antoniog11/iris-hardware/README.md

# IRIS Ring Hardware
KiCad schematic and PCB design for [IRIS: Wireless ring for vision-based smart home interaction](https://dl.acm.org/doi/10.1145/3654777.3676327).
