antoniog11/iris-hardware/balsamic 2.kicad_pcb

## KiCad design balsamic 2.kicad_pcb (2025-05-01)

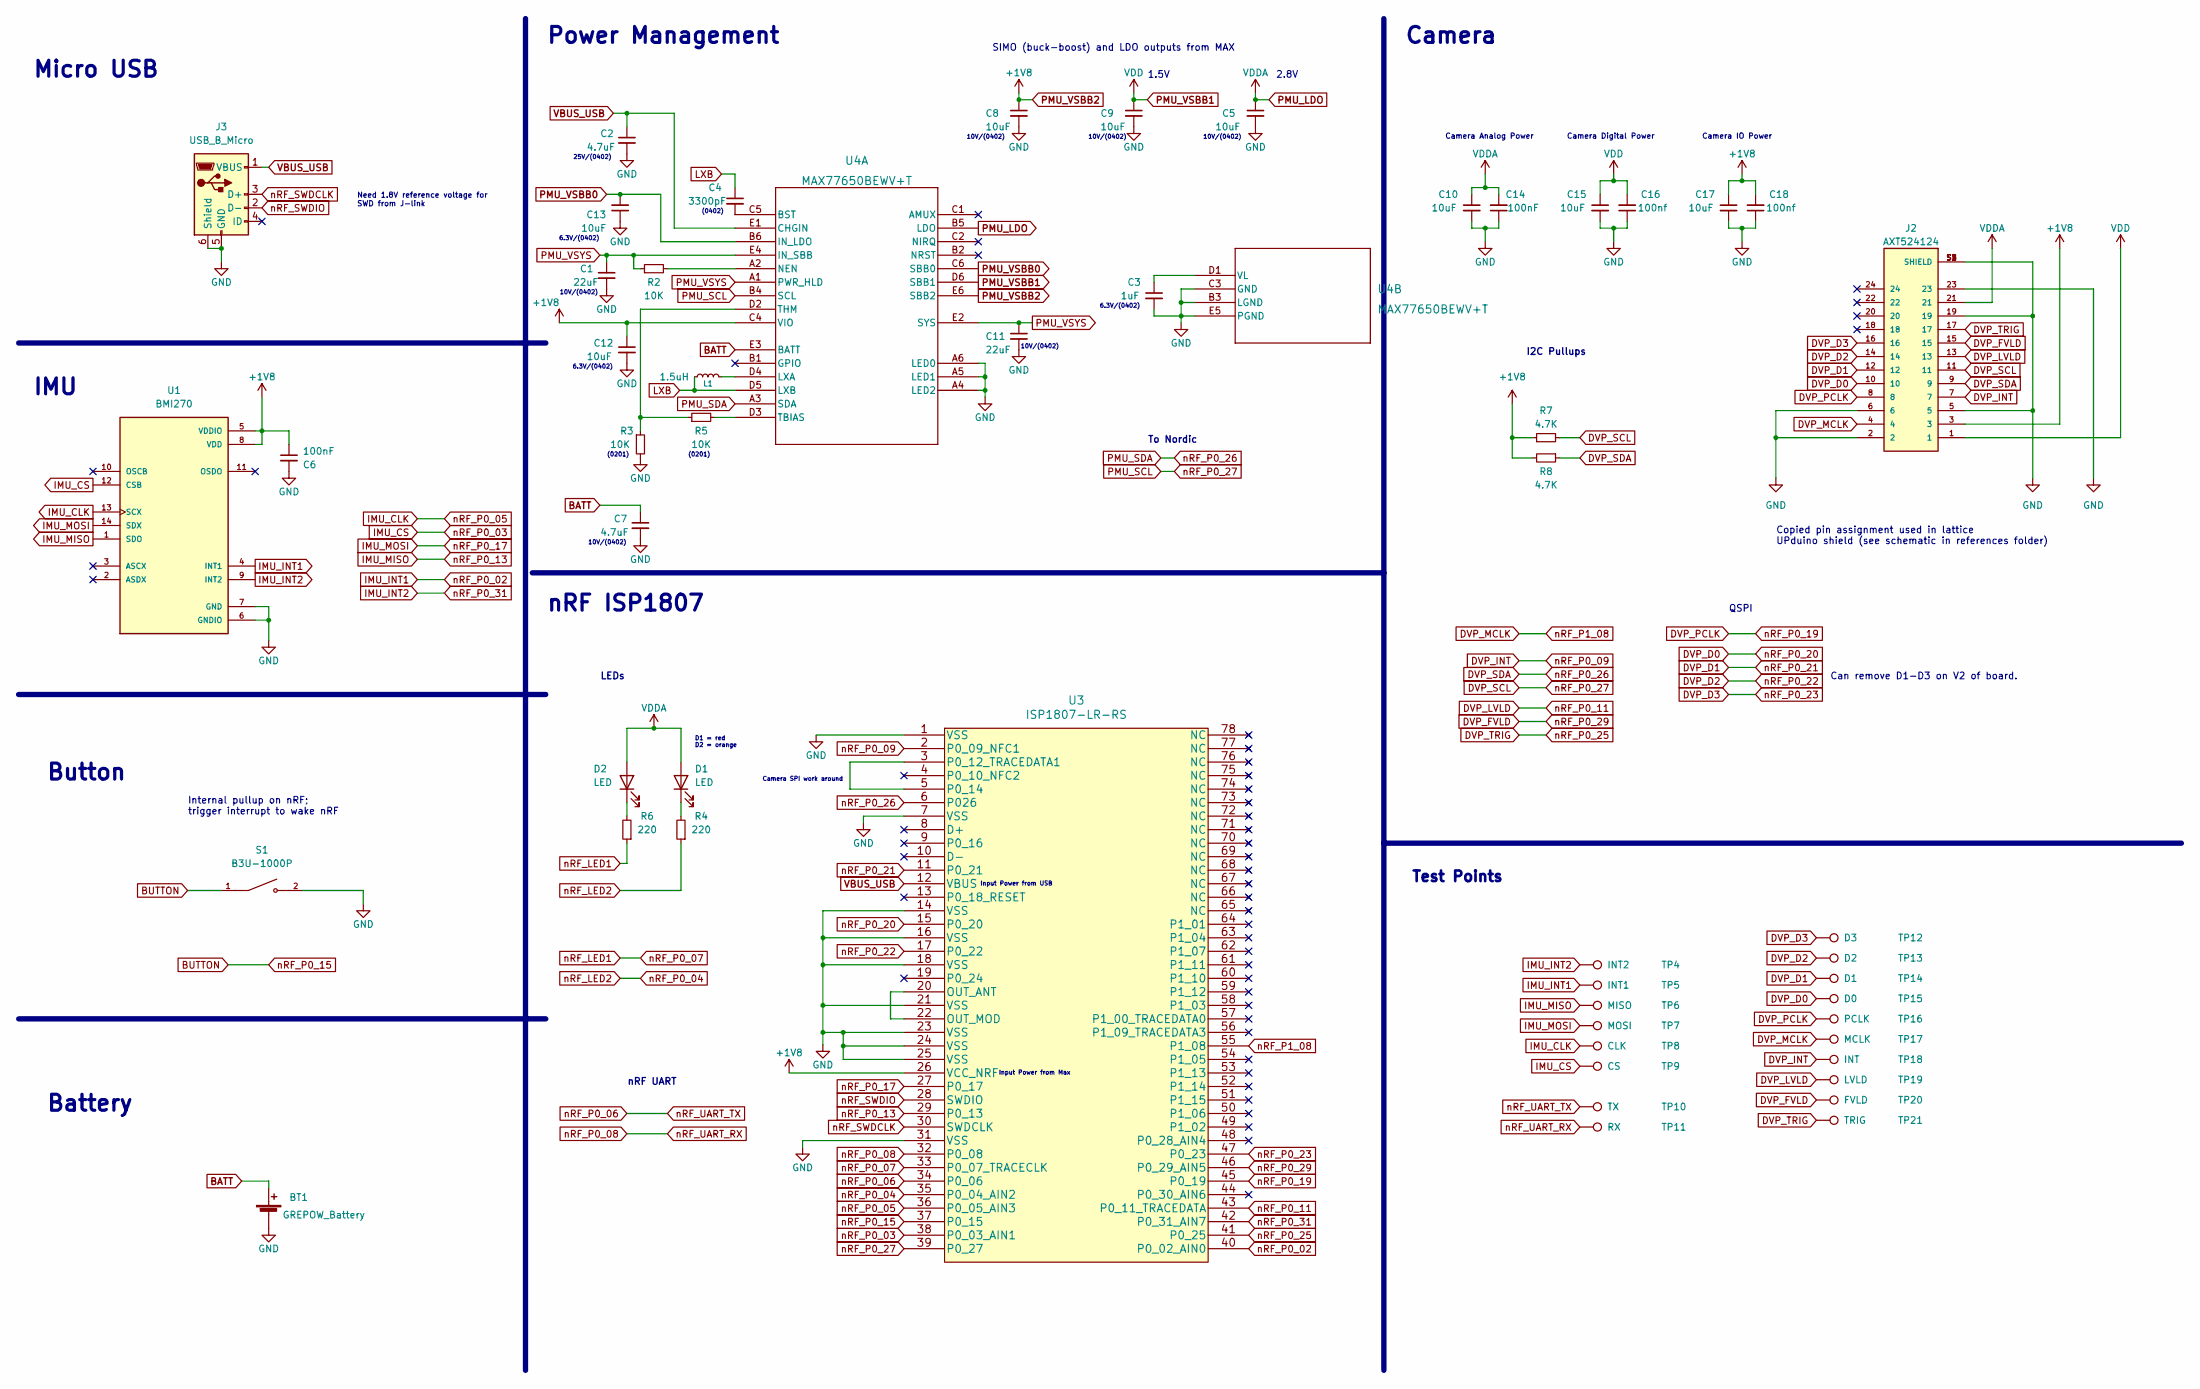
[picture p1: schematic balsamic 2.kicad_sch]

Parts:
BT1: GREPOW_Battery; balsamic_grepow_battery
C1, C11: 22uF; C_0402_1005Metric
C2, C7: 4.7uF; C_0402_1005Metric
C3: 1uF; C_0402_1005Metric
C4: 3300pF; C_0402_1005Metric
C5, C8, C9, C12, C13, C15, C17: 10uF; C_0402_1005Metric
C6, C14: 100nF; C_0201_0603Metric
C10: 10uF; C_0402_1005Metric_Pad0.74x0.62mm_HandSolder
C16, C18: 100nf; C_0201_0603Metric
D1, D2: LED; LED_0402_1005Metric
J2: AXT524124; PANASONIC_AXT524124
J3: USB_B_Micro; USB_Micro-B_GCT_USB3076-30-A
L1: 1.5uH; L_0805_2012Metric
R2, R3, R5: 10K; R_0201_0603Metric
R4, R6: 220; R_0201_0603Metric
R7, R8: 4.7K; R_0201_0603Metric
S1: B3U-1000P; SW_B3U-1000P
TP4: INT2; TestPoint_Pad_D0.5mm
TP5: INT1; TestPoint_Pad_D0.5mm
TP6: MISO; TestPoint_Pad_D0.5mm
TP7: MOSI; TestPoint_Pad_D0.5mm
TP8: CLK; TestPoint_Pad_D0.5mm
TP9: CS; TestPoint_Pad_D0.5mm
TP10: TX; TestPoint_Pad_D0.5mm
TP11: RX; TestPoint_Pad_D0.5mm
TP12: D3; TestPoint_Pad_D0.5mm
TP13: D2; TestPoint_Pad_D0.5mm
TP14: D1; TestPoint_Pad_D0.5mm
TP15: D0; TestPoint_Pad_D0.5mm
TP16: PCLK; TestPoint_Pad_D0.5mm
TP17: MCLK; TestPoint_Pad_D0.5mm
TP18: INT; TestPoint_Pad_D0.5mm
TP19: LVLD; TestPoint_Pad_D0.5mm
TP20: FVLD; TestPoint_Pad_D0.5mm
TP21: TRIG; TestPoint_Pad_D0.5mm
U1: BMI270; XDCR_BMI270
U3: ISP1807-LR-RS
U4: MAX77650BEWV+T; 21-100047A_W302H2&plus_1_MXM

Connections:
BATT: BT1.1 (+), C7.1, U4.E3 (BATT); also elsewhere on the board
BUTTON: S1.1, U3.37 (P0_15)
DVP_D0: J2.10, TP15.1, U3.15 (P0_20)
DVP_D1: J2.12, TP14.1, U3.11 (P0_21)
DVP_D2: J2.14, TP13.1, U3.17 (P0_22)
DVP_D3: J2.16, TP12.1, U3.47 (P0_23)
DVP_FVLD: J2.15, TP20.1, U3.46 (P0_29_AIN5)
DVP_INT: J2.7, TP18.1, U3.2 (P0_09_NFC1)
DVP_LVLD: J2.13, TP19.1, U3.43 (P0_11_TRACEDATA)
DVP_MCLK: J2.4, TP17.1, U3.55 (P1_08)
DVP_PCLK: J2.8, TP16.1, U3.45 (P0_19)
DVP_SCL: J2.11, R7.2, U3.39 (P0_27), U4.B4 (SCL)
DVP_SDA: J2.9, R8.1, U3.6 (P026), U4.A3 (SDA)
DVP_TRIG: J2.17, TP21.1, U3.41 (P0_25)
GND: BT1.2 (-), C1.2, C2.2, C3.2, C5.2, C6.2, C7.2, C8.2, C9.2, C10.2, C11.2, C12.2, C13.1, C14.1, C15.2, C16.1, C17.2, C18.1, J2.2, J2.5, J2.6, J2.19, J2.23, J2.S1 (SHIELD), J2.S2 (SHIELD), J2.S3 (SHIELD), J2.S4 (SHIELD), J3.5 (GND), J3.6 (Shield), R3.2, S1.2, U1.6 (GNDIO), U1.7 (GND), U3.1 (VSS), U3.7 (VSS), U3.14 (VSS), U3.16 (VSS), U3.18 (VSS), U3.21 (VSS), U3.23 (VSS), U3.24 (VSS), U3.25 (VSS), U3.31 (VSS), U4.A4 (LED2), U4.A5 (LED1), U4.A6 (LED0), U4.B3 (LGND), U4.C3 (GND), U4.E5 (PGND); also elsewhere on the board
IMU_CLK: TP8.1, U1.13 (SCX), U3.36 (P0_05_AIN3)
IMU_CS: TP9.1, U1.12 (CSB), U3.38 (P0_03_AIN1)
IMU_INT1: TP5.1, U1.4 (INT1), U3.40 (P0_02_AIN0)
IMU_INT2: TP4.1, U1.9 (INT2), U3.42 (P0_31_AIN7)
IMU_MISO: TP6.1, U1.1 (SDO), U3.29 (P0_13)
IMU_MOSI: TP7.1, U1.14 (SDX), U3.27 (P0_17)
LXB: C4.1, L1.1, U4.D5 (LXB)
unnamed: C4.2, U4.C5 (BST)
unnamed: D1.1 (K), R4.2
unnamed: D2.1 (K), R6.2
unnamed: L1.2, U4.D4 (LXA)
unnamed: R2.2, U4.A2 (NEN)
unnamed: R3.1, R5.1, U4.D2 (THM)
unnamed: R5.2, U4.D3 (TBIAS)
unnamed: U3.3 (P0_12_TRACEDATA1), U3.5 (P0_14)
unnamed: U3.20 (OUT_ANT), U3.22 (OUT_MOD)
unnamed: C3.1, U4.D1 (VL)
PMU_LDO: C5.1, C10.1, C14.2, D1.2 (A), D2.2 (A), J2.21, U4.B5 (LDO)
PMU_VSBB0: C13.2, U4.B6 (IN_LDO), U4.C6 (SBB0)
PMU_VSBB1: C9.1, C15.1, C16.2, J2.1, U4.D6 (SBB1)
PMU_VSBB2: C6.1, C8.1, C12.1, C17.1, C18.2, J2.3, R7.1, R8.2, U1.5 (VDDIO), U1.8 (VDD), U3.26 (VCC_NRF), U4.C4 (VIO), U4.E6 (SBB2)
PMU_VSYS: C1.1, C11.1, R2.1, U4.A1 (PWR_HLD), U4.E2 (SYS), U4.E4 (IN_SBB)
VBUS_USB: C2.1, J3.1 (VBUS), U3.12 (VBUS), U4.E1 (CHGIN)
nRF_LED1: R6.1, U3.33 (P0_07_TRACECLK)
nRF_LED2: R4.1, U3.35 (P0_04_AIN2)
nRF_P0_06: TP10.1, U3.34 (P0_06)
nRF_P0_08: TP11.1, U3.32 (P0_08)
nRF_SWDCLK: J3.3 (D+), U3.30 (SWDCLK)
nRF_SWDIO: J3.2 (D-), U3.28 (SWDIO)

Notes on the sheet:
2.8V
Battery
Button
10V/(0402)
D1 = red D2 = orange
1.5V
Camera IO Power
6.3V/(0402)
Input Power from USB
Input Power from Max
Test Points
Camera SPI work around
(0402)
To Nordic
Camera Digital Power
(0201)
nRF ISP1807
Micro USB
Can remove D1-D3 on V2 of board.
Internal pullup on nRF; trigger interrupt to wake nRF
SIMO (buck-boost) and LDO outputs from MAX
Copied pin assignment used in lattice UPduino shield (see schematic in references folder)
Camera Analog Power
LEDs
nRF UART
QSPI
Camera
I2C Pullups
25V/(0402)
Need 1.8V reference voltage for SWD from J-link
IMU
Power Management

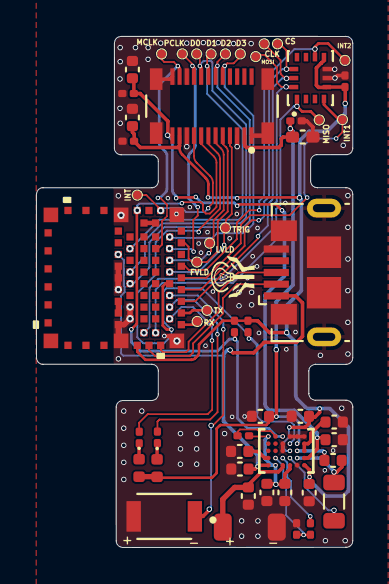
[picture p2: board balsamic 2.kicad_pcb from above]

Board: 2 copper layers, 17.6 x 28.4 mm, 53 parts (0 on the bottom side), 44 nets.

Other parts of the board:
BT2: GREPOW_Battery; balsamic_grepow_battery

Their connections:
BATT: BT2.1 (+); also elsewhere on the board
GND: BT2.2 (-); also elsewhere on the board
